x-heep/x-heep/docs/source/FPGA/HLS_DotProduct_Example.md

# HLS Accelerator Example: Streaming Dot Product

This guide documents a worked example of integrating an HLS-generated accelerator into X-HEEP, both in Verilator simulation and on the `pynq-z2` FPGA. It doubles as a template for adding your own HLS-generated IP to the project.

The same accelerator -- a small streaming dot-product engine written in C/C++, wired into X-HEEP as a memory-mapped accelerator -- can be generated with any of three HLS tools, selected with a FuseSoC flag:

| HLS tool | Flag | Directory | Needs on the host |
|---|---|---|---|
| [Vitis HLS](https://www.xilinx.com/products/design-tools/vitis/vitis-hls.html) (commercial) | `use_vitis_hls` | `hw/fpga/hls/vitis/dot_product/` | Vivado + Vitis HLS (`settings64.sh` sourced) |
| [Bambu HLS](https://github.com/ferrandi/PandA-bambu) (open source) | `use_bambu_hls` | `hw/fpga/hls/bambu/dot_product/` | Docker only |
| [Dynamatic](https://github.com/EPFL-LAP/dynamatic) (open source) | `use_dynamatic_hls` | `hw/fpga/hls/dynamatic/dot_product/` | Docker only |

Everything else -- the OBI wrapper, the AXI&harr;OBI bridges, the testbench and FPGA hookup, and the **software** -- is shared, so `example_dot_product_hls` runs unchanged with any of them.

```{note}
This whole example is opt-in and gated behind FuseSoC flags: `use_hls_example` plus one tool flag (`use_vitis_hls`, `use_bambu_hls` or `use_dynamatic_hls`). Without them, X-HEEP never depends on any HLS tool being installed -- building and simulating the project works exactly as before. See [Design: opt-in via FuseSoC flags](#design-opt-in-via-fusesoc-flags) below.
```

```{note}
The Vitis flow has been tested with `Vivado 2021.1` and `Vitis HLS 2021.1`. The Bambu flow has been tested with Bambu `2024.10` (in its Docker image, Verilator 4.038 inside the container) and X-HEEP's Verilator 5 system simulation, with the very same firmware as the Vitis flow. The Dynamatic flow has been tested with Dynamatic at commit `2fac291` (2026-09-23, in its Docker image, Verilator 5.040 inside the container), X-HEEP's Verilator 5.040 system simulation, again with the same firmware, and a `Vivado 2021.1` pynq-z2 bitstream.
```

## Repository layout

```
hw/fpga/hls/
├── common/dot_product/          shared by every HLS flow
│   ├── dot_product.h            C/C++ interface (types, prototype)
│   ├── dot_product_tb.cpp       C++ testbench (used by all three tools)
│   ├── dot_product_xheep_wrapper.sv   OBI wrapper + AXI<->OBI bridges
│   ├── dot_product.core         FuseSoC core epfl:ip:dot_product (selects the tool)
│   ├── dot_product.vlt          Verilator waivers for the shared part
│   ├── data/dot_product_ctrl.hjson   CTRL register map (input of regtool), Bambu + Dynamatic flows
│   ├── dot_product_ctrl.core    FuseSoC core of the register file (runs regtool)
│   ├── dot_product_ctrl.vlt     Verilator waivers for the regtool output
│   ├── rtl/dot_product_ctrl_regs.sv   AXI-Lite -> regbus -> regtool reg_top + core handshake
│   └── tb/
│       ├── dot_product_ctrl_regs_tb.sv  self-checking unit test of the register file
│       └── run.sh                       runs it with Verilator
├── vitis/dot_product/           Vitis HLS flow
│   ├── dot_product.cpp          the kernel, with Vitis pragmas
│   ├── run_hls.tcl              vitis_hls script (synthesis)
│   ├── generate_core.sh         runs it, copies the RTL, writes dot_product_vitis.core
│   ├── dot_product_vitis.core   FuseSoC core (committed; lists the generated RTL)
│   ├── dot_product.vlt          Verilator waivers for Vitis' generated RTL
│   └── rtl/dot_product_hls_adapter.sv   Vitis core <-> AXI structs
├── bambu/                       Bambu HLS flow
│   ├── Dockerfile, bambu.sh     runs Bambu (in Docker by default)
│   └── dot_product/
│       ├── dot_product.cpp      the kernel, with Bambu pragmas
│       ├── run_bambu.sh         synthesis (and standalone RTL co-simulation)
│       ├── generate_core.sh     runs it, copies the RTL, writes dot_product_bambu.core
│       ├── dot_product_bambu.core   FuseSoC core (committed; lists the generated RTL)
│       ├── dot_product.vlt      Verilator waivers for Bambu's generated RTL
│       └── rtl/dot_product_hls_adapter.sv   register file + Bambu core <-> AXI structs
└── dynamatic/                   Dynamatic flow
    ├── Dockerfile, dynamatic.sh runs Dynamatic (in Docker by default)
    └── dot_product/
        ├── dot_product.c        the kernel (C, no pragmas; includes the shared testbench)
        ├── run_dynamatic.sh     synthesis (and standalone RTL co-simulation)
        ├── generate_core.sh     runs it, copies the RTL, writes dot_product_dynamatic.core
        ├── dot_product_dynamatic.core   FuseSoC core (committed; lists the generated RTL)
        ├── dot_product.vlt      Verilator waivers for Dynamatic's generated RTL
        ├── rtl/
        │   ├── dot_product_hls_adapter.sv     register file + operand fetch + circuit handshake
        │   └── dot_product_operand_buffer.sv  fetches one vector over AXI into a local RAM
        └── tb/
            ├── dot_product_adapter_tb.sv  self-checking test of the adapter with the circuit
            └── run.sh                     runs it with Verilator
```

Generated files (`dot_product_proj/` and `rtl/hls/` in each flow, and the regtool output `common/dot_product/rtl/dot_product_ctrl_reg_{top,pkg}.sv`) are gitignored.

## What the accelerator does

`dot_product` computes the dot product of two `int32_t` vectors `a` and `b` of a given `size`, accumulating into a 64-bit result. The kernel is written in C/C++ (`dot_product.h` is shared; each flow has its own kernel file: the Vitis and Bambu ones are identical except for the interface pragmas, the Dynamatic one uses fixed-size arrays and returns the result, see [Running Dynamatic](#running-dynamatic)) and seen from X-HEEP it has two kinds of AXI ports:

- **`gmem_a` / `gmem_b`** -- two independent AXI4 master (read) ports. The accelerator fetches both vectors from memory on its own; no data ever passes through software. (With Vitis and Bambu the HLS core issues these reads itself; with Dynamatic its adapter does, see below.)
- **`CTRL`** -- one AXI4-Lite slave port bundling the two base addresses, `size`, the 64-bit `result`, and the standard Vitis HLS `ap_ctrl_hs` handshake (`ap_start`/`ap_done`/`ap_idle`/`ap_ready`). Vitis HLS generates this register file itself; Bambu and Dynamatic cannot, so their flows share an equivalent one, generated with [regtool](../How_to/RegGenerator.md) from `common/dot_product/data/dot_product_ctrl.hjson` like the other X-HEEP peripherals' register files, **with the same register map and (nearly all) bit semantics**, which is what keeps the software unchanged.

| Offset | Register | Description |
|---|---|---|
| `0x00` | `AP_CTRL` | bit 0 `ap_start` (write 1 to start), bit 1 `ap_done` (clear on read), bit 2 `ap_idle`, bit 3 `ap_ready` (clear on read), bit 7 `auto_restart` |
| `0x10` | `a` | base address of vector `a` |
| `0x1c` | `b` | base address of vector `b` |
| `0x28` | `size` | number of elements |
| `0x30` / `0x34` | `result` (lo/hi) | 64-bit accumulated dot product |
| `0x38` | `result_ctrl` | bit 0: result valid (clear on read) |

The regtool register file (Bambu and Dynamatic flows) also implements the interrupt registers of the Vitis-generated block (`GIER` at `0x04`, `IER` at `0x08`, `ISR` at `0x0c`) and an interrupt output, which -- as in the Vitis flow -- is not connected to anything in X-HEEP. `ISR` is write-1-to-clear here, where the Vitis block toggles the bit on write; the two are identical for the normal use (clearing a bit that is set).

Two behaviours follow from the register file being a regtool one, as for every other X-HEEP peripheral (and differ from the Vitis-generated block, which is more permissive): accessing an unmapped offset (`0x18`, `0x24`, `0x2c`, `0x3c`) returns a bus error, and a write whose byte strobes do not cover the whole register is rejected with a bus error (use 32-bit accesses; the byte-wide control registers only need byte 0).

One more regtool property is handled inside the register file: if software clears a bit (clear-on-read `ap_done`/`ap_ready`/result-valid, or write-1-to-clear `ISR`) in the very same clock cycle in which the hardware sets it, software wins and the hardware set is lost. The core pulses `done` only once, so a poll of `AP_CTRL` landing in that exact cycle would have made `ap_done` vanish and left the caller polling forever (this happened in the first system simulation). `dot_product_ctrl_regs.sv` therefore repeats every such hardware set until the bit reads back as set; it stops the cycle the bit is seen, so an event can be repeated but never doubled.

```{note}
**Why are `a`/`b` only 32 bits from software's side, if HLS ports are 64-bit?** (Vitis flow)
Vitis HLS derives the `gmem_a`/`gmem_b` AXI address width from the size of the C++ pointer type in `dot_product.cpp` (`const int32_t *`). Since `vitis_hls` runs as a 64-bit host process, it synthesizes 64-bit `m_axi` address ports (`a`/`b` are each a pair of 32-bit registers in hardware, at `0x10`/`0x14` and `0x1c`/`0x20`) -- this is inherent to how Vitis HLS compiles native pointers, not an X-HEEP design choice. X-HEEP only has a 32-bit address space, so `xheep_axi_to_obi_bridge` truncates the AXI address down to 32 bits before it reaches the OBI bus.

The upper 32-bit half of each pointer register (`0x14`, `0x20`) resets to `0` in the HLS-generated CTRL block and nothing else ever writes it, so it stays `0` without software ever touching it -- the 64-bit-pointer detail is entirely internal to the accelerator and invisible from X-HEEP's/software's point of view. `example_dot_product_hls/main.c` only ever writes the low word.

Bambu is invoked with `--compiler=I386_CLANG16`, i.e. it targets a 32-bit address space like X-HEEP's, so its `gmem_a`/`gmem_b` addresses are natively 32 bits. A Dynamatic circuit has no addresses at all (it indexes its arrays); its adapter forms 32-bit addresses from the base registers. The shared register file keeps the `0x14`/`0x20` words for register-map compatibility, as plain read/write registers that neither core uses.
```

Since X-HEEP's bus is OBI, not AXI, two small reusable bridges do the protocol conversion (both under `hw/ip/`, independent of `dot_product` and reusable for any future AXI-based accelerator):

- **`xheep_obi_to_axi_bridge`** -- OBI master (e.g. the CPU) &rarr; AXI4-Lite slave. Used for the `CTRL` port.
- **`xheep_axi_to_obi_bridge`** -- AXI4 master &rarr; OBI master. Used for `gmem_a` and `gmem_b`, so the accelerator's own memory reads become ordinary OBI transactions into X-HEEP's system bus.

`hw/fpga/hls/common/dot_product/dot_product_xheep_wrapper.sv` ties the generated `dot_product` core and the bridges together into a single clean module exposing three plain OBI ports: one OBI slave (`ctrl_obi_*`) and two OBI masters (`gmem_a_obi_*`, `gmem_b_obi_*`). It is **shared by all the HLS flows** -- the testbench and FPGA top instantiate it identically whichever tool is used.

The only tool-specific piece is a small module, `dot_product_hls_adapter`, that each flow provides in its own `rtl/` directory with the same ports: one AXI4-Lite slave (`CTRL`) and two AXI4 read masters, all as PULP AXI structs. It maps whatever flat ports and port names the tool emits onto those structs:

- **Vitis**: connects the generated core (upper-case Xilinx names such as `m_axi_gmem_a_ARVALID`, an `s_axi_CTRL_*` port) and ties off `AWATOP`/`lock`.
- **Bambu**: instantiates the CTRL register file (`dot_product_ctrl_regs`), connects the generated core (lower-case names such as `m_axi_gmem_a_arvalid`, plain `start_port`/`done_port`/`a`/`b`/`size`/`result` ports), adapts the 6-bit ids and 32-bit addresses to the wrapper's structs, and ties off `AWATOP` and `cache_reset`.
- **Dynamatic**: instantiates the same register file, two operand buffers that fetch `a` and `b` over `gmem_a`/`gmem_b` into local RAMs, and the generated circuit, whose handshake channels (start/`size` tokens in; result, end tokens out) it drives -- see [The Dynamatic adapter](#the-dynamatic-adapter).

## Differences between the flows

The accelerator's behaviour and register map are the same, but the tools differ in what they can express and emit, which is why the kernels (and the hand-written glue) are not identical:

| | Vitis HLS | Bambu HLS | Dynamatic |
|---|---|---|---|
| Scheduling | Static, II-based pipeline | Static (FSM + datapath) | Dynamic: a dataflow circuit of handshake (valid/ready) channels; each operation fires when its operands arrive |
| Kernel source | C++ with `#pragma HLS` interface/pipeline pragmas | C++ with Bambu's `#pragma HLS interface` | C, no pragmas: fixed-size arrays instead of pointers (`a[1024]`), the result is the return value, `main()` in the same file |
| Interface it emits | AXI4-Lite `s_axilite` register file with `ap_ctrl_hs`, AXI4 masters | `clock`/`reset`/`start_port`/`done_port`, a plain port per C argument, AXI4 masters | Handshake channels (`start`, `size`, result `out0`, `end`, a start/end token pair per array) and a BRAM-like port per array: fixed one-cycle read latency, not elastic, no stall |
| CTRL registers | Generated by the tool | Regtool register file (`common/dot_product/`) | Same regtool register file |
| Interface pragma | `#pragma HLS INTERFACE m_axi port=a offset=slave bundle=gmem_a ...` | `#pragma HLS interface port=a mode=m_axi offset=direct bundle=gmem_a` (lower-case, case sensitive; only `offset=direct`) | None (no interface directives) |
| `a`, `b` | Base addresses live in generated registers (`offset=slave`) | Plain address input ports, driven by the register file (`offset=direct`) | No addresses in the circuit (it indexes its arrays); the adapter reads `base + 4 * index` |
| Operand fetch | The core's AXI masters: bursts up to 256 beats, 2 outstanding reads (`max_read_burst_length`, `num_read_outstanding`) | The core's AXI masters: single-beat, in-order transactions (`ARLEN = 0`); no equivalent options | The adapter copies `a`/`b` into two local 1024-word RAMs over AXI4 (single-beat, pipelined), then starts the circuit, which reads the RAMs |
| Maximum `size` | None (`LOOP_TRIPCOUNT` hint: 4096) | None | 1024 (the array size; larger values are clamped, and `example_dot_product_hls` stops at compile time with a larger `TEST_DATA_SIZE`) |
| Loop pipelining | `#pragma HLS PIPELINE II=1` | No such pragma; the scheduler decides | Implicit: iterations overlap as far as the dataflow dependencies allow (here the 64-bit accumulation) |
| Address width | 64-bit (host pointers) | 32-bit (`--compiler=I386_CLANG16`) | 32-bit (formed by the adapter) |
| Reset | Active-low `ap_rst_n` | Active-low `reset` | Active-high, synchronous `rst` |
| HDL emitted | Verilog | Verilog, one self-contained file | Verilog with `write-hdl --hdl verilog` (its default is VHDL, which Verilator cannot read), one file per component |
| Host dependencies | Vivado + Vitis HLS (licensed) | Docker | Docker |
| Docker image | -- | `xheep-bambu:2024.10`, ~5 GB: the release AppImage (~1.4 GB download), SHA-256 checked | `xheep-dynamatic:2fac291`, ~4.1 GB: Dynamatic built from source at a pinned commit, against its prebuilt LLVM (~0.8 GB download, SHA-256 checked), plus Verilator 5.040 |
| One-off setup | Tool install | Image build: download-bound, a few minutes | Image build: ~12 minutes on a 16-core host (compiling Dynamatic and Verilator) |
| RTL generation (this kernel, 16-core host) | ~26 s (`csynth_design`) | ~11 s | ~2 s (`compile` + `write-hdl`); co-simulation ~30 s |

The single-beat AXI master means the Bambu version fetches operands with lower throughput than the burst-capable Vitis one, and the Dynamatic version fetches both vectors completely before computing (see [The Dynamatic adapter](#the-dynamatic-adapter)).

## Design: opt-in via FuseSoC flags

Passing `--flag use_hls_example` plus **exactly one** of `--flag use_vitis_hls` / `--flag use_bambu_hls` / `--flag use_dynamatic_hls` to any `fusesoc`-driven build (via `FUSESOC_FLAGS`) does the following, all defined in `core-v-mini-mcu.core` and `hw/fpga/hls/common/dot_product/dot_product.core`:

1. `use_hls_example` defines the SystemVerilog macro `` `USE_HLS_EXAMPLE `` (a `vlogdefine` parameter), which gates every instantiation of the accelerator in `tb/testharness.sv.tpl` and `hw/fpga/xilinx_core_v_mini_mcu_wrapper.sv` behind `` `ifdef USE_HLS_EXAMPLE ``.
2. `use_hls_example` also makes `epfl:ip:dot_product` (the shared core: wrapper, bridges) a dependency of the simulation (`tb/x-heep-tb-utils.core`) and FPGA (`rtl-fpga` fileset) builds. Without the flag, FuseSoC never even looks for this core or any generated RTL.
3. The tool flag makes `epfl:ip:dot_product` depend on that tool's core -- `epfl:ip:dot_product_vitis` (`use_vitis_hls`), `epfl:ip:dot_product_bambu` (`use_bambu_hls`) or `epfl:ip:dot_product_dynamatic` (`use_dynamatic_hls`), which provide the `dot_product_hls_adapter` module and the generated RTL.
4. The tool flag also registers a `pre_build` hook, `generate_hls_dot_product_vitis`, `generate_hls_dot_product_bambu` or `generate_hls_dot_product_dynamatic`, which runs that flow's `generate_core.sh` (i.e. the HLS tool) automatically before the build -- so passing the flags is enough; you never have to run the HLS step yourself.

Without the flags, no generated Verilog needs to exist on disk, and nothing in X-HEEP requires any HLS tool to be installed.

```{warning}
Pass exactly one tool flag together with `use_hls_example`. With `use_hls_example` alone, no adapter is pulled in and the build fails on the unresolved module `dot_product_hls_adapter`.
```

## Simulating with Verilator

Generate the MCU, then build and run as usual, adding the flags. With **Vitis HLS**:

```sh
source <vivado-installation-path>/settings64.sh
source <vitis_hls-installation-path>/settings64.sh

make mcu-gen
make verilator-build FUSESOC_FLAGS="--flag use_hls_example --flag use_vitis_hls"
make app PROJECT=example_dot_product_hls TARGET=sim
make verilator-run FUSESOC_FLAGS="--flag use_hls_example --flag use_vitis_hls"
```

With **Bambu HLS** (no Xilinx tools needed, only Docker -- see [Running Bambu](#running-bambu)):

```sh
make mcu-gen
make verilator-build FUSESOC_FLAGS="--flag use_hls_example --flag use_bambu_hls"
make app PROJECT=example_dot_product_hls TARGET=sim
make verilator-run FUSESOC_FLAGS="--flag use_hls_example --flag use_bambu_hls"
```

With **Dynamatic** (only Docker as well -- see [Running Dynamatic](#running-dynamatic)):

```sh
make mcu-gen
make verilator-build FUSESOC_FLAGS="--flag use_hls_example --flag use_dynamatic_hls"
make app PROJECT=example_dot_product_hls TARGET=sim
make verilator-run FUSESOC_FLAGS="--flag use_hls_example --flag use_dynamatic_hls"
```

`example_dot_product_hls` (`sw/applications/example_dot_product_hls/main.c`) writes the two vector addresses and `size` into the `CTRL` registers, pulses `ap_start`, polls `ap_done`, and checks the result against a CPU-computed reference, returning `EXIT_SUCCESS` (`Program Finished with value 0`) when they match. On FPGA it also prints (its `PRINTF` is disabled in simulation, so `uart0.log` stays empty there):

```
Dot Product Accelerator Successful: 0x0000000000000330 in 139 cycles
```

The cycle count is the `mcycle` CSR, cleared just before the registers are programmed and read once `ap_done` is seen: the whole offload as the CPU sees it, polling included (one poll takes 9 cycles with the Vitis core and 10 with the Bambu and Dynamatic ones, which is the resolution). With `size` = 16 it is 73 cycles with the Vitis core, 139 with the Bambu one and 160 with the Dynamatic one in the Verilator simulation. It grows with `size`: 1024 elements take about 1400 cycles with Vitis (2 cycles per element up to 256 elements, then its bursts help), 6500 with Bambu (6 to 7 per element) and 7500 with Dynamatic (7 to 8 per element). To see it in simulation, set `PRINTF_IN_SIM` to 1 in `main.c`: the line then lands in `uart0.log`, and the total simulated cycles grow by about 27000 because of the `printf`.

```{note}
Sourcing Vivado's and Vitis HLS's `settings64.sh` is only required for the Vitis flow (`use_vitis_hls` triggers the Vitis HLS synthesis hook). The Bambu and Dynamatic flows only need Docker, and a plain `make verilator-build` (no flags) never needs either.
```

## Building and programming the pynq-z2 bitstream

Follow the same flow as any other FPGA build (see [Run on FPGA](./RunOnFPGA.md)), adding the flag:

```sh
source <vivado-installation-path>/settings64.sh
source <vitis_hls-installation-path>/settings64.sh   # Vitis flow only

make vivado-fpga FPGA_BOARD=pynq-z2 FUSESOC_FLAGS="--flag use_hls_example --flag use_vitis_hls"
# or, with the open-source Bambu HLS or Dynamatic (Vivado is still needed for the bitstream itself):
make vivado-fpga FPGA_BOARD=pynq-z2 FUSESOC_FLAGS="--flag use_hls_example --flag use_bambu_hls"
make vivado-fpga FPGA_BOARD=pynq-z2 FUSESOC_FLAGS="--flag use_hls_example --flag use_dynamatic_hls"

make vivado-fpga-pgm FPGA_BOARD=pynq-z2
```

With any of the three tools, the build meets timing at the 8 ns system clock (`Vivado 2021.1`). Without the flags, `make vivado-fpga FPGA_BOARD=pynq-z2` builds the exact same bitstream as before this example existed -- no accelerator, no extra logic, no HLS-tool dependency.

### How the accelerator is wired on FPGA

Unlike the testbench (which uses a small dedicated crossbar for external masters/slaves), `core_v_mini_mcu` on FPGA is normally built "unextended" (`EXT_XBAR_NMASTER=0`, no external masters at all). Adding the accelerator without pulling in a full crossbar uses two different mechanisms, both only active under `` `ifdef USE_HLS_EXAMPLE ``:

- **`gmem_a` / `gmem_b`** (the accelerator's own two memory-read masters) are wired to `x_heep_system`'s `ext_xbar_master_req_i`/`resp_o` ports, with `EXT_XBAR_NMASTER` overridden to `2`. These genuinely go through X-HEEP's real system crossbar, since there are two masters that need arbitration for the shared memory/peripheral space.
- **`CTRL`** (the single OBI slave the CPU configures) is wired directly to `ext_core_data_req_o`/`ext_core_data_resp_i` -- X-HEEP's existing per-master address demux already gives the CPU's data bus a dedicated "external slave" output for the `EXT_SLAVE_START_ADDRESS` region (`0xC000_0000`, the same region the testbench and software already use), completely independent of the internal crossbar. Since there is exactly one master on that path, no arbitration/crossbar is needed at all -- it's a direct point-to-point connection.

This wiring lives in `hw/fpga/xilinx_core_v_mini_mcu_wrapper.sv`, scoped to the non-PS-enabled FPGA boards (pynq-z2 included).

## Running Bambu

The Bambu flow runs Bambu inside a Docker container by default, so **Docker is the only host dependency** (no Xilinx tools, no 32-bit toolchain, no Verilator install). The `use_bambu_hls` pre-build hook takes care of everything; this section describes what happens underneath and how to run the steps by hand.

- **The container.** `hw/fpga/hls/bambu/bambu.sh` runs Bambu in the `xheep-bambu:2024.10` image, building it from `hw/fpga/hls/bambu/Dockerfile` the first time it is needed (one-off: it downloads Bambu's release AppImage, ~1.4 GB, and produces a ~5 GB image). The Bambu version is pinned and the download is checked against a SHA-256, so a changed file fails the build. The container runs as your user (generated files are yours), has no network access, and sees the X-HEEP checkout at the same path as on the host.
- **A native install instead.** Set `BAMBU=/path/to/bambu` (and, for from-source installs, `BAMBU_ENV=/path/to/settings.sh`) to skip Docker. A native Bambu additionally needs a 32-bit toolchain (`g++-multilib`) and Verilator for co-simulation.
- **Generating the RTL.** `hw/fpga/hls/bambu/dot_product/generate_core.sh` (what the hook runs) calls `run_bambu.sh`, copies Bambu's output into `rtl/hls/` and regenerates `dot_product_bambu.core`. Bambu writes the whole design -- the top and every library component it uses -- into a single self-contained `dot_product.v`.
- **Checking the HLS result on its own.** `run_bambu.sh sim` co-simulates the generated RTL against the shared C++ testbench through Bambu's own Verilator flow and AXI memory model, and checks for `TEST PASSED`:

  ```sh
  cd hw/fpga/hls/bambu/dot_product
  ./run_bambu.sh sim
  ```

  ```
  expected = 816, got = 816
  TEST PASSED
  ```

  This validates the HLS output only, not the X-HEEP integration (adapter, register file, wrapper, bridges); that is what the Verilator system simulation above is for. Bambu's co-simulation also prints a one-off `ERROR: MDPI driver: Interface 3: Unknown data required: 4.` line before the test runs; the test still passes and returns 0, and the message is not from X-HEEP's code.

  `run_bambu.sh` with no argument only synthesizes. Everything is generated in `dot_product_proj/` (gitignored).
- **Unit test of the register file.** `common/dot_product/rtl/dot_product_ctrl_regs.sv` (shared with the Dynamatic flow) replaces a block that Vitis generates, so it has its own self-checking testbench, which drives it over AXI4-Lite against a small model of the core and checks the behaviour described by the Vitis-generated register map: reset values, the one-cycle start pulse, clear-on-read of `ap_done`/`ap_ready`/result-valid, `auto_restart`, the interrupt registers, the bus errors above, AW/W arriving in either order, and a sweep of software polls across every cycle alignment with the core's done pulse (the race above). It needs Verilator 5 plus what any X-HEEP FuseSoC build needs (the register file is generated by regtool through FuseSoC, see `util/python-requirements.txt`), but no HLS tool, and prints `dot_product_ctrl_regs_tb: PASS`:

  ```sh
  hw/fpga/hls/common/dot_product/tb/run.sh
  ```
- **The testbench.** `common/dot_product/dot_product_tb.cpp` is shared with the other flows. Bambu's co-simulation needs to be told how many bytes each pointer argument points to, so the testbench has a small block guarded by `#ifdef __BAMBU_SIM__` (a macro only Bambu defines) that calls `m_param_alloc()`; Vitis never sees it. Likewise `dot_product.h` gives `dot_product()` C linkage, because Bambu names the generated RTL module after the (mangled) C++ symbol and would otherwise call it `_Z11dot_productPKiS0_jPx`.
- **Target device.** `run_bambu.sh` targets `xc7z020,-1,clg484` at 8 ns, the same clock as the Vitis flow. Bambu has a timing/area model for the `clg484` package, not for the pynq-z2's `clg400` (same die and speed grade), so this only affects Bambu's estimates; Vivado implements the design for the real part.

## Running Dynamatic

[Dynamatic](https://github.com/EPFL-LAP/dynamatic) is EPFL-LAP's dynamically scheduled HLS compiler, built on MLIR: it turns a C kernel into a *dataflow circuit*, a network of components connected by handshake (valid/ready) channels, where each operation fires as soon as its operands arrive, instead of following a schedule fixed at compile time. Like the Bambu flow, the Dynamatic flow runs the tool inside a Docker container, so **Docker is the only host dependency**, and the `use_dynamatic_hls` pre-build hook takes care of everything. This section describes what happens underneath and how to run the steps by hand.

- **The container.** `hw/fpga/hls/dynamatic/dynamatic.sh` runs a script of Dynamatic shell commands (`set-src`, `compile`, `write-hdl`, `simulate`, ...; one per line, ending with `exit`) non-interactively, with `bin/dynamatic --exit-on-failure --run <script>`, in the `xheep-dynamatic:2fac291` image. It builds the image from `hw/fpga/hls/dynamatic/Dockerfile` the first time it is needed. Dynamatic publishes no binaries or images, so the image builds it from source: Dynamatic is pinned to a git commit (`2fac291`, 2026-09-23), LLVM/MLIR/clang come from the prebuilt release tarball that Dynamatic's own `build.sh --use-prebuilt-llvm` uses (~0.8 GB, checked against the SHA-256 GitHub publishes for it; building LLVM from scratch would take 50+ GB and 16 GB of RAM), and Verilator 5.040 (pinned to its tag's commit) is built for Dynamatic's co-simulation. This is a one-off: about 12 minutes on a 16-core machine, for a ~4.1 GB image. As with Bambu, the container runs as your user, has no network access, and sees the X-HEEP checkout at the same path as on the host.
- **A native install instead.** Set `DYNAMATIC_DIR=/path/to/dynamatic` (the top-level directory of a built Dynamatic) to skip Docker. Co-simulation then also needs Verilator >= 5.024 on the host.
- **Generating the RTL.** `hw/fpga/hls/dynamatic/dot_product/generate_core.sh` (what the hook runs) calls `run_dynamatic.sh`, which stages the kernel with the shared header and testbench into `dot_product_proj/` (Dynamatic only looks for includes next to the kernel and writes its output next to it), runs `compile` and `write-hdl --hdl verilog` at an 8 ns clock target (no MILP solver, so no Gurobi), and copies the Verilog into `rtl/hls/`: one file per component of the circuit (its RTL library, specialised per width), `dot_product.v` (the circuit) and `dot_product_wrapper.v` (the top level). Before regenerating `dot_product_dynamatic.core` it strips the `` `timescale `` lines (as in the Bambu flow) and adds the final newline that some files of Dynamatic's library lack (Verilator 5.040 otherwise ignores the file-scoped waivers of `dot_product.vlt` for them). The generated modules have generic names (`mux`, `sink`, `addi`, ...); none of them clashes with a module of X-HEEP.
- **The kernel.** `dot_product.c` is C, named after the kernel (Dynamatic takes the kernel name from the file name), with no pragmas. Dynamatic accepts neither pointer arguments nor results written through a pointer, so `a`/`b` are fixed-size arrays and the result is the return value. Defining `DOT_PRODUCT_DYNAMATIC` before including `dot_product.h` selects that signature, with arrays of `DOT_PRODUCT_DYNAMATIC_MAX_LEN` (1024) elements. Despite Dynamatic's documentation listing `int64_t` among the unsupported types, the 64-bit accumulator and result synthesize and co-simulate correctly at this commit (checked with full-range signed data in the adapter test below).
- **Checking the HLS result on its own.** `run_dynamatic.sh sim` adds Dynamatic's `simulate --simulator verilator`: the kernel file is compiled as C++ with the shared testbench (which `dot_product.c` includes under `__cplusplus`, and which uses Dynamatic's `CALL_KERNEL()` under `DOT_PRODUCT_DYNAMATIC`) to record the inputs and expected outputs, then Dynamatic's testbench replays them on the generated Verilog and compares:

  ```sh
  cd hw/fpga/hls/dynamatic/dot_product
  ./run_dynamatic.sh sim
  ```

  ```
  expected = 816, got = 816
  TEST PASSED
  ...
  [INFO  HLS_VERIFIER] C and VHDL outputs match
  ```

  (The message says VHDL whatever the HDL.) Dynamatic documents ModelSim/Questa for this step, but also supports Verilator, GHDL and xsim; the image uses Verilator, so no commercial simulator is needed. Its Verilator testbench needs Verilator >= 5.024, which is why the image builds 5.040 rather than using Ubuntu 24.04's 5.020. This validates the HLS output only, not the X-HEEP integration; the adapter test and the system simulation do that.
- **Test of the adapter.** `tb/run.sh` runs a self-checking Verilator test of `dot_product_hls_adapter` with the generated circuit and the shared register file inside: it programs the CTRL registers over AXI4-Lite like the firmware, serves `gmem_a`/`gmem_b` from a memory model with random request backpressure and response latency, and checks the 64-bit signed result against a reference for sizes 0 to 1024 plus a clamped one, what is fetched from memory, that arguments are sampled at start, auto-restart, and a sweep of software polls across every cycle alignment with the done event (the race described above). It generates the circuit first if needed, and prints `dot_product_adapter_tb: PASS`:

  ```sh
  hw/fpga/hls/dynamatic/dot_product/tb/run.sh
  ```

### The Dynamatic adapter

A Dynamatic circuit has neither the CTRL register file nor the AXI masters of the other cores. The top level, `dot_product_wrapper`, has:

- handshake channels: `start` (control) and `size` (32-bit) in; `out0` (the 64-bit result) and `end` out; and for each array a control token pair, `a_start` in and `a_end` out (likewise for `b`), which bracket the circuit's accesses to that array;
- for each array, a BRAM-like port: a write port (`a_ce0`/`a_we0`/`a_address0`/`a_dout0`, unused for a `const` array) and a read port (`a_ce1`/`a_address1`, with the data expected on `a_din1` exactly one cycle later);
- `clk` and an active-high synchronous `rst`; no clock enable.

The memory port is the hard part: a read through the bridges and X-HEEP's bus takes several cycles and can be back-pressured, while the circuit expects the data in the next cycle and has no way to wait for it. These options were considered, in this order:

1. **A latency-insensitive memory interface from Dynamatic.** There is none at this commit. Its [circuit-interface specification](https://github.com/EPFL-LAP/dynamatic/blob/2fac2911faf35b84156e08782a9fcfe8fc6174d8/docs/DeveloperGuide/DesignDecisionProposals/CircuitInterface.md) states that its ad-hoc memory interfaces "are *not* elastic, which should be fixed in the future", and the AXI wrapper it describes is a proposal. (Dynamatic also has a pass that turns calls to external C functions into handshake channels at the top level, which would be elastic; its current frontend rejects such calls, though: "Function calls are not currently supported".)
2. **Copying `a` and `b` into local RAMs before starting the circuit.** Chosen. Simple and deterministic, and the circuit reads exactly the BRAM it was designed for. Costs: two 1024-word RAMs (8 KB in all) and a fetch phase before the computation, instead of fetching while computing; the engine still fetches its own operands over `gmem_a`/`gmem_b`, without software.
3. **Stalling the circuit while a read is in flight.** Not possible without gating its clock, since the generated RTL has no clock enable; rejected.

So `rtl/dot_product_hls_adapter.sv` sequences each run as: on `ap_start`, sample `a`, `b` and `size` (clamped to 1024); the two `dot_product_operand_buffer` instances fetch `size` words each, in parallel, with single-beat AXI4 reads (as many in flight as the bridge accepts), into a single-port X-HEEP `sram_wrapper` each; then the circuit gets its `start`, `size`, `a_start` and `b_start` tokens and reads the RAMs; once it has produced `out0`, `end`, `a_end` and `b_end`, the result and done go to the register file. In the Verilator simulation, the fetch and computation of 1024 elements take about 7500 cycles with the adapter test's randomly slow memory.

The operands are not streamed in while the circuit computes because only the circuit's interior is elastic. Its memory read data (`a_din1`) has no valid, and the generated memory controller raises its own `ldData_valid` one cycle after granting a request (`read_data_signals` in `rtl/hls/mc_support.v`), assuming a one-cycle memory. The "how many words are in" handshake is therefore the adapter's: `dot_product_operand_buffer` counts the received words, and the circuit only gets its `start` token once both buffers are full. Starting earlier would not be safe, since a circuit that cannot be stalled would read stale data whenever the bus is slow. A FIFO in place of the pre-filled RAMs would suit this kernel, which reads `a[i]` and `b[i]` in order, once each. However, popping only when the FIFO is not empty needs the circuit to wait for data, and that needs a data-valid inside its generated memory controller (`dot_product.v`), which means patching generated RTL. It is the latency-insensitive memory interface that Dynamatic does not have yet: see the ["Memory Interface"](https://github.com/EPFL-LAP/dynamatic/blob/2fac2911faf35b84156e08782a9fcfe8fc6174d8/docs/DeveloperGuide/DesignDecisionProposals/CircuitInterface.md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) section of Dynamatic's circuit-interface specification.

Fetching and computing never overlap, which is what lets each RAM be single-port. Dynamatic's specification guarantees that a circuit only accesses an array between consuming `<array>_start` and producing `<array>_end`. At this commit its memory controller only partly enforces that (`<array>_start` does not gate its loads, and `<array>_end` does not wait for loads still in flight, as a note in its source says), so the guarantee here comes from this kernel's dataflow graph (`dot_product_proj/out/comp/handshake_export.mlir`). Its only two loads take their address from the loop index, which does not exist before the circuit consumes its `start` and `size` tokens. Their data feeds the accumulator, so the result cannot exist before every load has completed, and the adapter waits for the result before it can start another fill. A kernel change that adds a load whose value does not reach the result would void this, so the adapter and the buffers check it in simulation (`` `ifndef SYNTHESIS `` blocks that `$fatal` if the circuit reads a buffer outside of a run or while it is being filled, produces an output outside of a run or twice, or uses a write port).

```{note}
**FPGA memories.** On FPGA, X-HEEP's `sram_wrapper` (generated from `hw/fpga/xheep_fpga_support/rtl/sram_wrapper.sv.tpl`, part of the vendored [x-heep-fpga-support](https://github.com/x-heep/x-heep-fpga-support)) maps each size to a Xilinx block-memory IP, and only has IPs for the configured RAM bank sizes (and the flash cache). Any other size, such as the 1024-word operand buffers, falls back to an inferred single-port block RAM (one RAMB36 per buffer), and Vivado prints a `sram_wrapper: no Xilinx memory IP for NumWords = 1024 ... falling back to an inferred block RAM` warning, which is expected.
```

## Extending: adding your own HLS accelerator

The pieces above are deliberately generic and reusable:

- `xheep_obi_to_axi_bridge` / `xheep_axi_to_obi_bridge` (`hw/ip/`) work for any AXI4 / AXI4-Lite port shape, not just `dot_product`'s.
- **Adding another HLS tool** only takes: a directory `hw/fpga/hls/<tool>/dot_product/` with the kernel in that tool's dialect, a `generate_core.sh` (see below), a generated `dot_product_<tool>.core` providing a `dot_product_hls_adapter` module with the same ports as the existing ones, a new `use_<tool>_hls` flag, a `generate_hls_dot_product_<tool>` hook in `core-v-mini-mcu.core`, and one more `use_<tool>_hls ? (epfl:ip:dot_product_<tool>)` line in `hw/fpga/hls/common/dot_product/dot_product.core`. A tool that cannot generate the CTRL register file reuses the regtool one (`x-heep:ip:dot_product_ctrl`), as the Bambu and Dynamatic flows do. Its `generate_core.sh` must also handle the `clean` argument without needing the tool (see below), and be added to `HLS_GENERATE_CORE_SCRIPTS` in the `Makefile`, which is what `make clean` iterates over. The wrapper, bridges, testbench/FPGA hookup and software don't change.
- `hw/fpga/hls/<tool>/dot_product/generate_core.sh` is a template for an HLS &rarr; FuseSoC `.core` generation script: it runs the tool (`vitis_hls -f run_hls.tcl` for Vitis, `run_bambu.sh` for Bambu, `run_dynamatic.sh` for Dynamatic) on the kernel, copies the resulting Verilog into the stable `rtl/hls/` directory, and regenerates `dot_product_<tool>.core` to list it. This is exactly the script the `generate_hls_dot_product_<tool>` pre-build hooks run for you -- you only need to touch it directly if you're modifying the kernel or `dot_product.h` and want to re-synthesize without rebuilding the whole simulation/bitstream.

  The script skips re-running the HLS tool (and doesn't need it installed) if `rtl/hls/` already holds RTL newer than the kernel, the shared header, the run script and the script itself (for Bambu and Dynamatic also the Docker environment) -- so repeated flagged builds don't re-synthesize every time. Set `FORCE=1` to regenerate unconditionally.

  To remove the generated artifacts (the HLS project, `rtl/hls/`, the tool logs and, for Bambu and Dynamatic, the regtool-generated CTRL register file in `common/dot_product/rtl/`) and force the next build to fully re-synthesize from scratch, `make clean` does it along with everything else, or on its own:

  ```sh
  make clean-hls
  ```

  which just runs the `clean` mode of each flow's script, so one flow can also be cleaned alone:

  ```sh
  hw/fpga/hls/vitis/dot_product/generate_core.sh clean
  hw/fpga/hls/bambu/dot_product/generate_core.sh clean
  hw/fpga/hls/dynamatic/dot_product/generate_core.sh clean
  ```

  None of these need the HLS tool (Vitis HLS in the `PATH`, or Bambu/Dynamatic/Docker). They intentionally leave `dot_product_<tool>.core` untouched: unlike `rtl/hls/` and `dot_product_proj/`, that file is committed to git, because FuseSoC needs it present to resolve `epfl:ip:dot_product_<tool>` as a dependency *before* any `pre_build` hook runs -- if it didn't exist at all, dependency resolution would fail outright and the hook that regenerates `rtl/hls/` would never get a chance to run.

  `FORCE=1` reaches `generate_core.sh` even though it's invoked indirectly, through the `generate_hls_dot_product_<tool>` pre-build hook, through FuseSoC, through `make`: GNU Make automatically exports a variable set on its command line into the environment of every recipe it runs, `fusesoc run --build` inherits that environment when it spawns the `pre_build` hook's subprocess, and the hook itself is just `['bash', '.../generate_core.sh']`, which sees `FORCE` like any other environment variable. So it's enough to set it on the `make` invocation, no extra plumbing needed:

  ```sh
  FORCE=1 make verilator-build FUSESOC_FLAGS="--flag use_hls_example --flag use_bambu_hls"
  FORCE=1 make vivado-fpga FPGA_BOARD=pynq-z2 FUSESOC_FLAGS="--flag use_hls_example --flag use_vitis_hls"
  ```

  ```{note}
  `pre_build` hooks -- and therefore `FORCE`/`generate_core.sh` -- only run as part of an actual FuseSoC `--build` (what `verilator-build` and `vivado-fpga` do). A `--setup`-only step, such as `make vivado-fpga-nobuild`, generates the project files but never invokes the hook, so it won't pick up `FORCE=1` or re-synthesize anything.
  ```
- `dot_product_proj/` (the HLS project) and `rtl/hls/` (the generated RTL) are both gitignored, like any other tool-generated file in this project -- they don't need to exist until the flags are used.
- The `use_hls_example` / tool flag mechanism in `core-v-mini-mcu.core` shows the places (parameter/`` `define ``, dependency, pre-build hook) a new opt-in HLS example needs to be wired into for both simulation and FPGA builds.
